hapcan/UNIV_3.1.0.x/Readme.md

UNIV 3.1.0.x
============

BUTTON MODULE - 8 close/open inputs

Device webpage: http://hapcan.com/devices/universal/univ_3/univ_3-1-0-x/

Hardware created in Eagle PCB Software http://www.cadsoftusa.com/

Firmware created in Microchip MPLAB http://www.microchip.com/mplabide/ in assembly language
