hapcan/UNIV_3.1.0.x/Hardware_UNIV_3.1.0.x/univ_3-1-0-x-label.docx

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
BUTTON

8 ON/OFF CHANNEL
TYPE | UNIV 3.1.0.x
S/N | 00000591h
BUS BUS | hapcan.com

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
PRZYCISK

8 KANAŁÓW WŁ./WYŁ.
TYP | UNIV 3.1.0.x
S/N | 00000591h
BUS BUS | hapcan.com
