hapcan/UNIV_3.1.0.x/Hardware_UNIV_3.1.0.x/rev2/pcb_univ_3-1-0-x-rev2.brd

## EAGLE design Hardware_UNIV_3.1.0.x/rev2/pcb_univ_3-1-0-x-rev2.brd (2015-10-12)

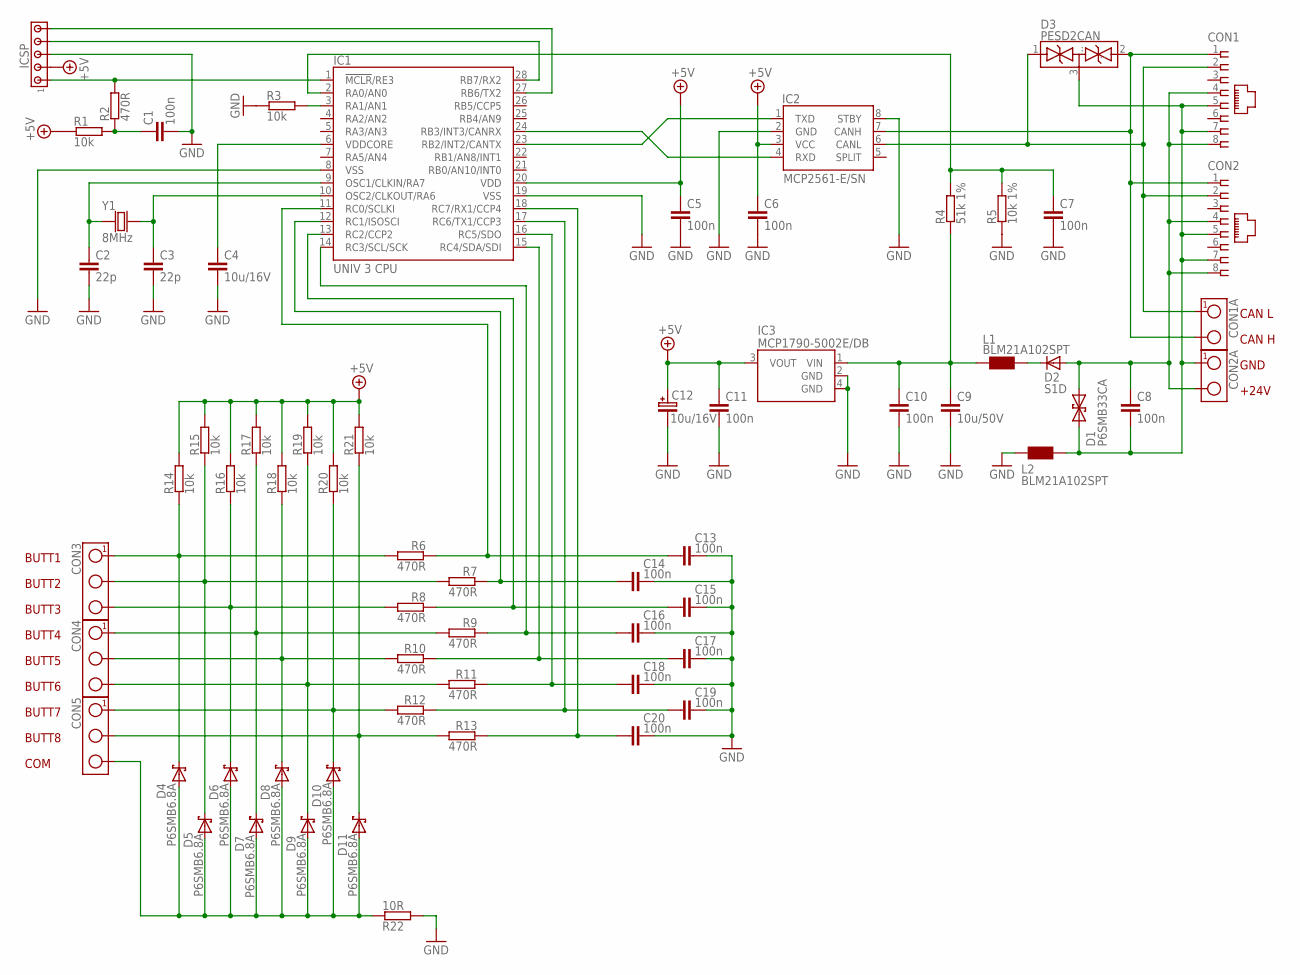
[picture p8: schematic pcb_univ_3-1-0-x-rev2.sch]

Parts:
C1, C5, C6, C7, C8, C10, C11, C13, C14, C15, C16, C17, C18, C19, C20: 100n; 0805
C2, C3: 22p; 0805
C4: 10u/16V; 0805
C9: 10u/50V; 1210
C12: 10u/16V; SMC_B
CON1, CON2: RJ45-SOCKET; RJ45-PCB-SOCKET
CON1A, CON2A: TERMINAL-2; ARK2-5X10,5MM
CON3, CON4, CON5: TERMINAL-3; ARK3-5X10.5MM
D1: P6SMB33CA; DO-214_TRANSIL2
D2: S1D; DO-214
D3: PESD2CAN; SOT-23
D4, D5, D6, D7, D8, D9, D10, D11: P6SMB6.8A; DO-214
IC1: UNIV 3 CPU; UNIV3CPU
IC2: MCP2561-E/SN; SO-08
IC3: MCP1790-5002E/DB; SOT-223
ICSP: HEADER5; SIP-5
L1, L2: BLM21A102SPT; 0805
R1, R3, R14, R15, R16, R17, R18, R19, R20, R21: 10k; 0805
R2, R6, R7, R8, R9, R10, R11, R12, R13: 470R; 0805
R4: 51k 1%; 0805
R5: 10k 1%; 0805
R22: 10R; 0805
Y1: 8MHz; CRYSTAL-HC49V

Connections:
+5V: C5.1, C6.1, C11.1, C12.+ (1), IC1.20 (VDD), IC2.3 (VCC), IC3.3 (VOUT), ICSP.2, R1.1, R14.2, R15.2, R16.2, R17.2, R18.2, R19.2, R20.2, R21.2
GND: C1.2, C2.2, C3.2, C4.2, C5.2, C6.2, C7.2, C9.2, C10.2, C11.2, C12.- (2), C13.2, C14.2, C15.2, C16.2, C17.2, C18.2, C19.2, C20.2, IC1.8 (VSS), IC1.19 (VSS), IC2.2 (GND), IC2.8 (STBY), IC3.2 (GND), IC3.4 (GND), ICSP.3, L2.1, R3.1, R5.1, R22.2
unnamed: CON5.3, D4.A, D5.A, D6.A, D7.A, D8.A, D9.A, D10.A, D11.A, R22.1
unnamed: IC1.24 (RB3/INT3/CANRX), IC2.4 (RXD)
unnamed: IC1.23 (RB2/INT2/CANTX), IC2.1 (TXD)
unnamed: CON1.1, CON1A.2, CON2.1, D3.2 (..), IC2.7 (CANH)
unnamed: CON3.1, D4.C, R6.2, R14.1
unnamed: CON3.3, D6.C, R8.2, R16.1
unnamed: C1.1, R1.2, R2.1
unnamed: IC1.1 (!MCLR!/RE3), ICSP.1, R2.2
unnamed: C8.1, CON1.4, CON1.8, CON2.4, CON2.8, CON2A.2, D1.A (1), D2.A
unnamed: IC1.28 (RB7/RX2), ICSP.4
unnamed: C14.1, IC1.12 (RC1/ISOSCI), R7.1
unnamed: IC1.3 (RA1/AN1), R3.2
unnamed: CON3.2, D5.C, R7.2, R15.1
unnamed: IC1.27 (RB6/TX2), ICSP.5
unnamed: C3.1, IC1.10 (OSC2/CLKOUT/RA6), Y1.2
unnamed: C7.1, IC1.2 (RA0/AN0), R4.2, R5.2
unnamed: C9.1, C10.1, IC3.1 (VIN), L1.1, R4.1
unnamed: C8.2, CON1.5, CON1.7, CON2.5, CON2.7, CON2A.1, D1.C (2), D3.3 (...), L2.2
unnamed: C15.1, IC1.13 (RC2/CCP2), R8.1
unnamed: CON4.1, D7.C, R9.2, R17.1
unnamed: C16.1, IC1.14 (RC3/SCL/SCK), R9.1
unnamed: CON4.3, D9.C, R11.2, R19.1
unnamed: CON5.1, D10.C, R12.2, R20.1
unnamed: C13.1, IC1.11 (RC0/SCLKI), R6.1
unnamed: CON1.2, CON1A.1, CON2.2, D3.1 (.), IC2.6 (CANL)
unnamed: C17.1, IC1.15 (RC4/SDA/SDI), R10.1
unnamed: CON4.2, D8.C, R10.2, R18.1
unnamed: CON5.2, D11.C, R13.2, R21.1
unnamed: C2.1, IC1.9 (OSC1/CLKIN/RA7), Y1.1
unnamed: C18.1, IC1.16 (RC5/SDO), R11.1
unnamed: C19.1, IC1.17 (RC6/TX1/CCP3), R12.1
unnamed: C20.1, IC1.18 (RC7/RX1/CCP4), R13.1
unnamed: C4.1, IC1.6 (VDDCORE)
unnamed: D2.C, L1.2

Notes on the sheet:
BUTT2
BUTT3
BUTT4
BUTT5
BUTT6
COM
BUTT1
BUTT7
BUTT8
CAN L
CAN H
GND
+24V

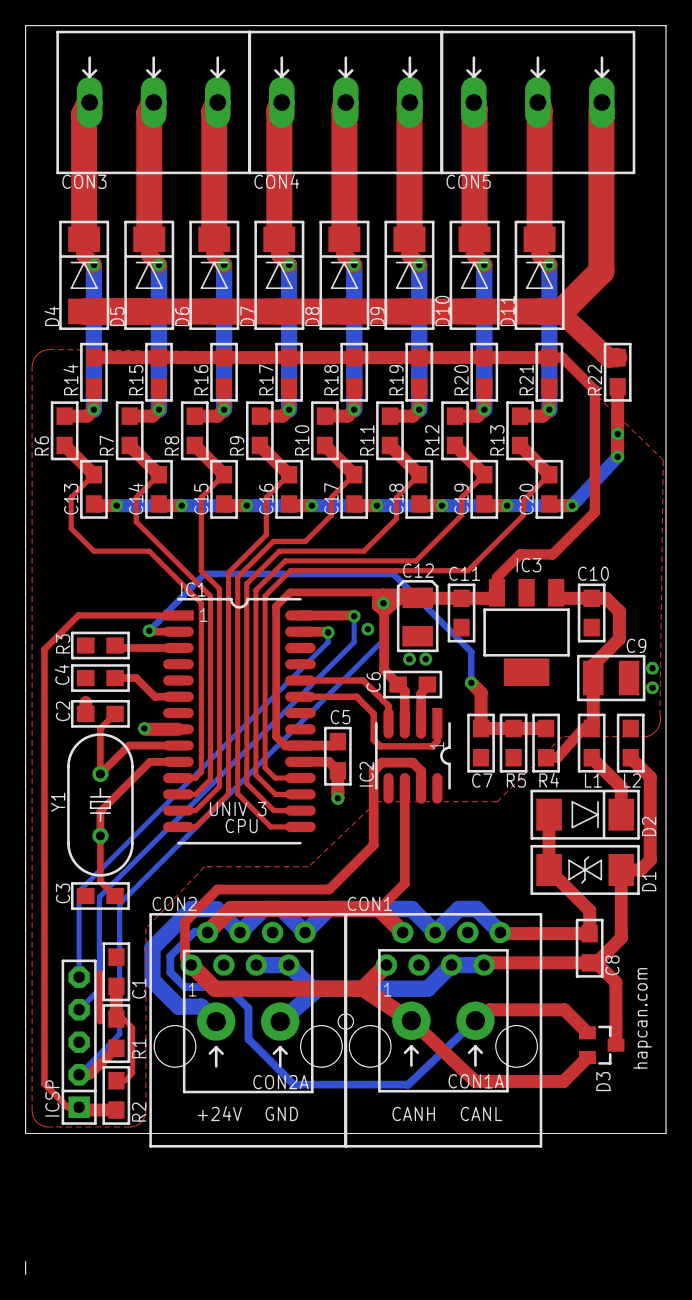
[picture p9: board pcb_univ_3-1-0-x-rev2.brd from above]

Board: 2 copper layers, 50.0 x 86.5 mm, 67 parts (0 on the bottom side), 36 nets.
