hapcan/UNIV_3.1.0.x/(commit log)

2013-09-25 hardware revision 1
    [pcb_univ_3-1-0-x-rev1.brd, pcb_univ_3-1-0-x-rev1.sch]
2013-09-25 firmware revision 0
    [univ_3-1-0-0-rev0-memory.xlsx]
2015-10-12 hardware UNIV 3.1.0.x revision 1
    [pcb_univ_3-1-0-x-rev1.brd, pcb_univ_3-1-0-x-rev1.sch, univ_3-1-0-x-rev1.sch]
2015-10-12 hardware UNIV 3.1.0.x revision 2
    [pcb_univ_3-1-0-x-rev2.brd, pcb_univ_3-1-0-x-rev2.sch, univ_3-1-0-x-rev2.sch]
2016-05-04 firmware UNIV 3.1.0.0 revision 1
    [univ_3-1-0-0-rev1-memory.xlsx]
2016-12-27 firmware UNIV 3.1.0.0 revision 2
    [univ_3-1-0-0-rev2-memory.xlsx]
2022-10-31 firmware UNIV 3.1.0.0 revision 3
    [univ_3-1-0-0-rev2-memory.xlsx]
